comradef191/usb3sun/hardware/THT-PCB/usb3sun-THT.kicad_pcb

## KiCad design hardware/THT-PCB/usb3sun-THT.kicad_pcb (2024-04-11)

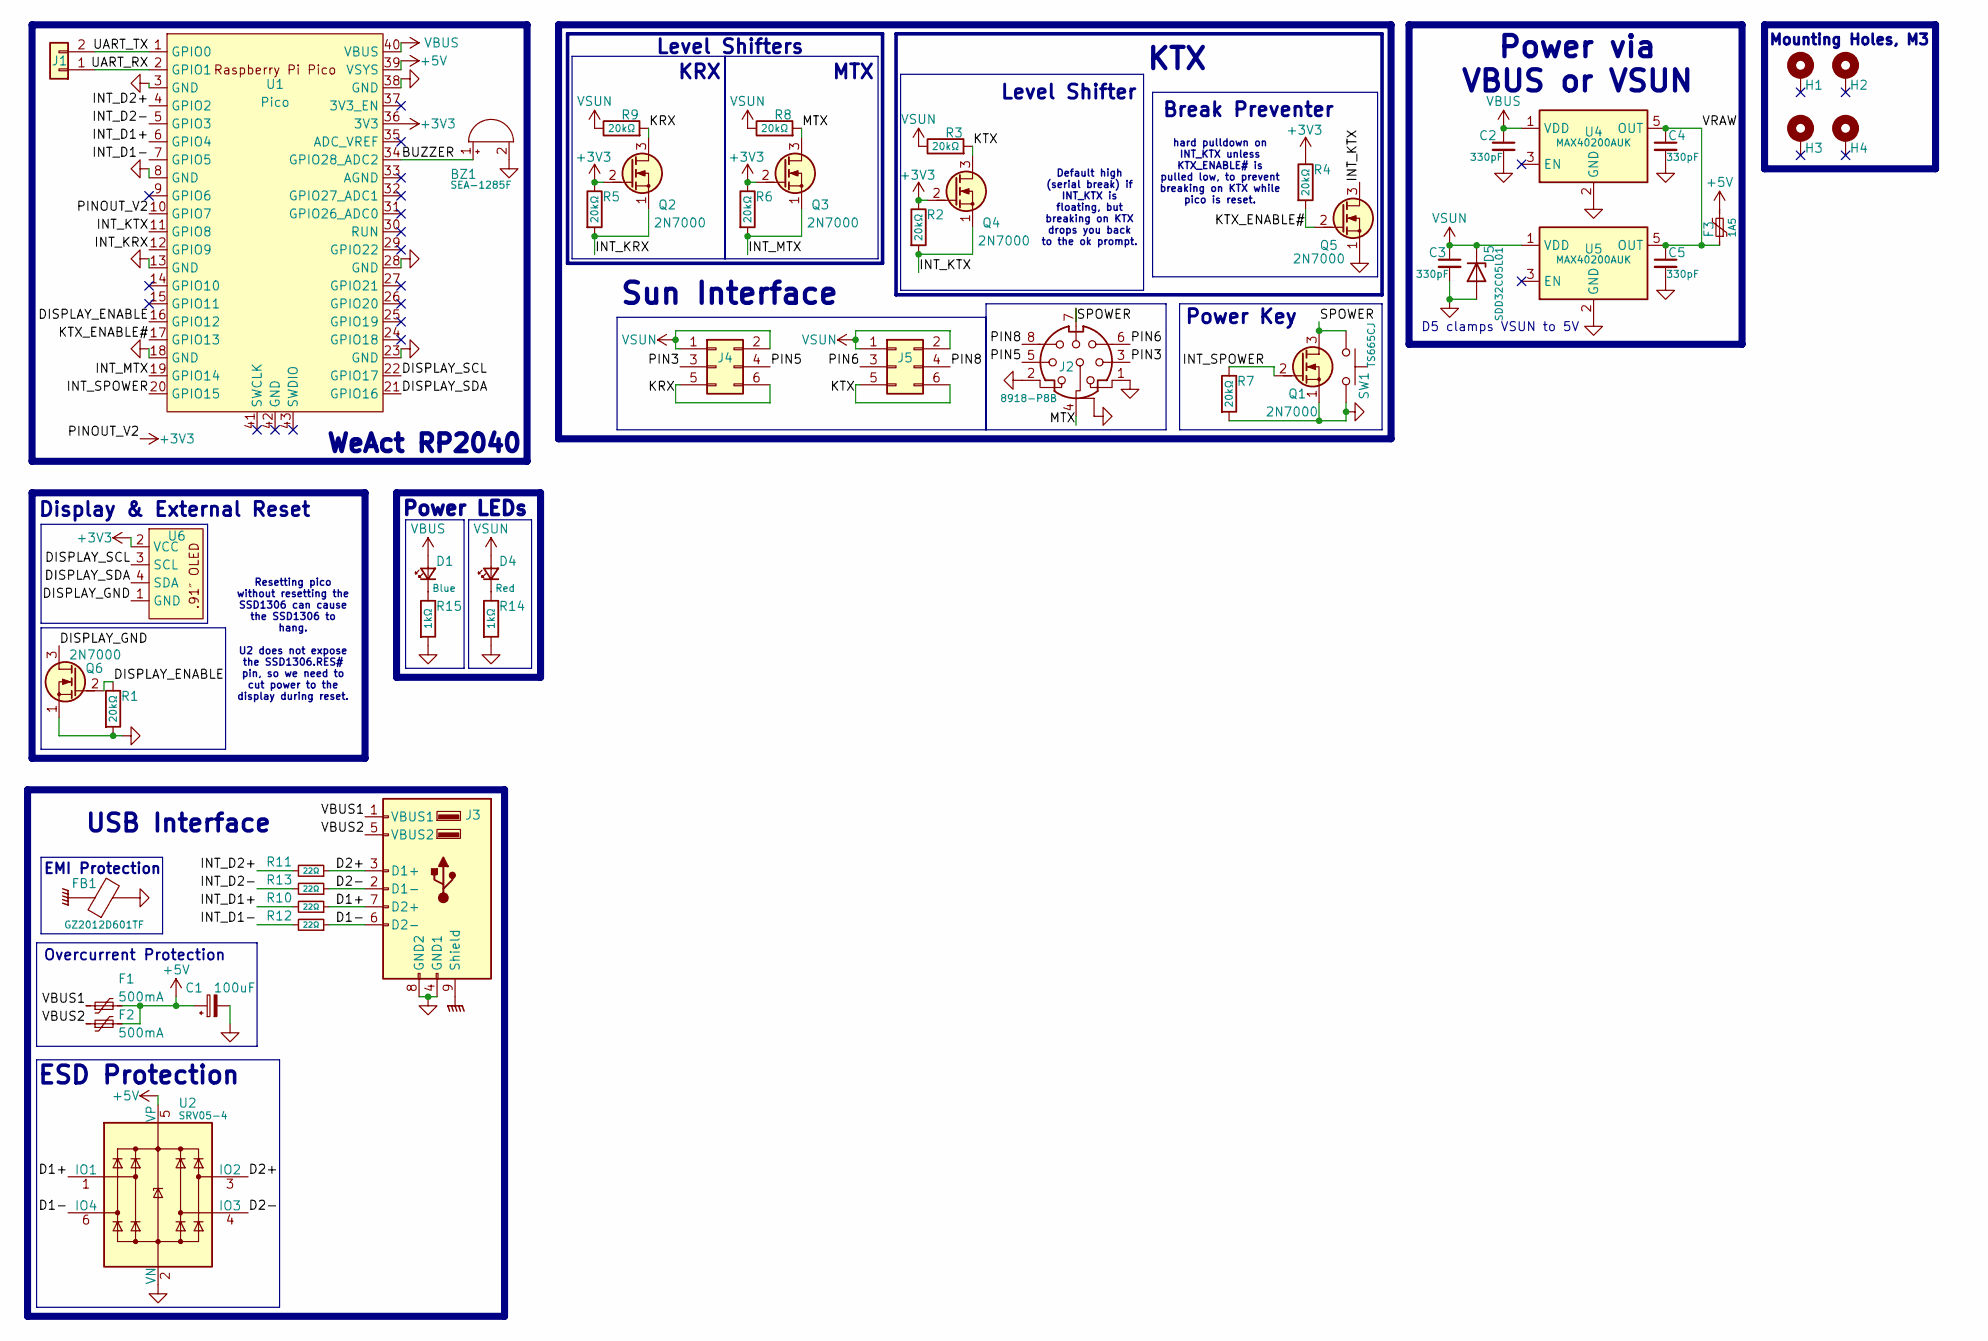
[picture p1: schematic usb3sun-THT.kicad_sch]

Parts:
BZ1: SEA-1285F; Buzzer_12x9.5RM7.6; LCSC C2693577
C1: 100uF; CP_EIA-3528-21_Kemet-B; LCSC C16133
C2, C3, C4, C5: 330pF; C_Disc_D3.8mm_W2.6mm_P2.50mm; LCSC C94711
D1: LED_D3.0mm; LCSC C2895474
D4: LED_D3.0mm; LCSC C440523
D5: SDD32C05L01; D_SOD-323_HandSoldering; LCSC C313311
F1, F2: 500mA; Fuse_1206_3216Metric; LCSC C70076
F3: 1A5; Fuse_1206_3216Metric; LCSC C70084
FB1: GZ2012D601TF; L_0805_2012Metric; LCSC C1017
H1, H2, H3, H4: MountingHole; MountingHole_3.2mm_M3_DIN965_Pad_TopBottom
J1: Conn_01x02; PinHeader_1x02_P2.54mm_Vertical
J2: 8918-P8B; Altronics_P1108_8918-P8B
J3: USB-U267-BWS; USB_A_CUI_UJ2-ADH-TH_Horizontal_Stacked; LCSC C2962392
J4, J5: Conn_02x03_Odd_Even; PinHeader_2x03_P2.54mm_Vertical
Q1, Q2, Q3, Q4, Q5, Q6: 2N7000; TO-92_Inline; LCSC C9114
R1, R2, R3, R4, R5, R6, R7, R8, R9: 20kΩ; R_Axial_DIN0207_L6.3mm_D2.5mm_P10.16mm_Horizontal
R10, R11, R12, R13: 22Ω; R_Axial_DIN0207_L6.3mm_D2.5mm_P10.16mm_Horizontal
R14, R15: 1kΩ; R_Axial_DIN0207_L6.3mm_D2.5mm_P10.16mm_Horizontal
SW1: TS665CJ; SW_PUSH_6mm_H4.3mm; LCSC C5340136
U1: Pico; Pico-BlackPill_Textless
U2: SRV05-4; SOT-23-6-routable; LCSC C85364
U4, U5: MAX40200AUK; SOT-23-5_HandSoldering; LCSC C2649430
U6: SSD1306-0.91-OLED-4pin-128x32

Connections:
+3V3: Q2.2 (G), Q3.2 (G), Q4.2 (G), R2.1, R4.1, R5.1, R6.1, U1.10 (GPIO7), U1.36 (3V3), U6.2 (VCC)
+5V: C1.1, F1.2, F2.2, F3.2, U1.39 (VSYS), U2.5 (VP)
/BUZZER: BZ1.1 (-), U1.34 (GPIO28_ADC2)
/D1+: J3.7 (D2+), R10.1, U2.1 (IO1)
/D1-: J3.6 (D2-), R12.1, U2.6 (IO4)
/D2+: J3.3 (D1+), R11.1, U2.3 (IO2)
/D2-: J3.2 (D1-), R13.1, U2.4 (IO3)
/DISPLAY_ENABLE: Q6.2 (G), R1.1, U1.16 (GPIO12)
/DISPLAY_GND: Q6.3 (D), U6.1 (GND)
/DISPLAY_SCL: U1.22 (GPIO17), U6.3 (SCL)
/DISPLAY_SDA: U1.21 (GPIO16), U6.4 (SDA)
/INT_D1+: R10.2, U1.6 (GPIO4)
/INT_D1-: R12.2, U1.7 (GPIO5)
/INT_D2+: R11.2, U1.4 (GPIO2)
/INT_D2-: R13.2, U1.5 (GPIO3)
/INT_KRX: Q2.1 (S), R5.2, U1.12 (GPIO9)
/INT_KTX: Q4.1 (S), Q5.3 (D), R2.2, U1.11 (GPIO8)
/INT_MTX: Q3.1 (S), R6.2, U1.19 (GPIO14)
/INT_SPOWER: Q1.2 (G), R7.1, U1.20 (GPIO15)
/KRX: J4.5, J4.6, Q2.3 (D), R9.2
/KTX: J5.5, J5.6, Q4.3 (D), R3.2
/KTX_ENABLE#: Q5.2 (G), R4.2, U1.17 (GPIO13)
/MTX: J2.4, Q3.3 (D), R8.2
/PIN3: J2.3, J4.3
/PIN5: J2.5, J4.4
/PIN6: J2.6, J5.3
/PIN8: J2.8, J5.4
/SPOWER: J2.7, Q1.3 (D), SW1.2
/UART_RX: J1.1, U1.2 (GPIO1)
/UART_TX: J1.2, U1.1 (GPIO0)
/VBUS1: F1.1, J3.1 (VBUS1)
/VBUS2: F2.1, J3.5 (VBUS2)
/VRAW: C4.1, C5.1, F3.1, U4.5 (OUT), U5.5 (OUT)
GND: BZ1.2 (+), C1.2, C2.2, C3.2, C4.2, C5.2, D5.2 (A), FB1.2, J2.1, J2.2, J2.SHIELD, J3.4 (GND1), J3.8 (GND2), Q1.1 (S), Q5.1 (S), Q6.1 (S), R1.2, R7.2, R14.2, R15.2, SW1.1, U1.3 (GND), U1.8 (GND), U1.13 (GND), U1.18 (GND), U1.23 (GND), U1.28 (GND), U1.38 (GND), U2.2 (VN), U4.2 (GND), U5.2 (GND)
GNDPWR: FB1.1, J3.9 (Shield)
unnamed: D1.1 (K), R15.1
unnamed: D4.1 (K), R14.1
VBUS: C2.1, D1.2 (A), U1.40 (VBUS), U4.1 (VDD)
VSUN: C3.1, D4.2 (A), D5.1 (K), J4.1, J4.2, J5.1, J5.2, R3.1, R8.1, R9.1, U5.1 (VDD)

Notes on the sheet:
Default high (serial break) if INT_KTX is floating, but breaking on KTX drops you back to the ok prompt.
hard pulldown on INT_KTX unless KTX_ENABLE# is pulled low, to prevent breaking on KTX while pico is reset.
Resetting pico without resetting the SSD1306 can cause the SSD1306 to hang. U2 does not expose the SSD1306.RES# pin, so we need to cut power to the display during reset.
KTX
WeAct RP2040
Mounting Holes, M3
Break Preventer
Overcurrent Protection
ESD Protection
Sun Interface
EMI Protection
Power Key
Power via VBUS or VSUN
Display & External Reset
USB Interface
KRX
D5 clamps VSUN to 5V
Level Shifters
MTX
Level Shifter
Power LEDs

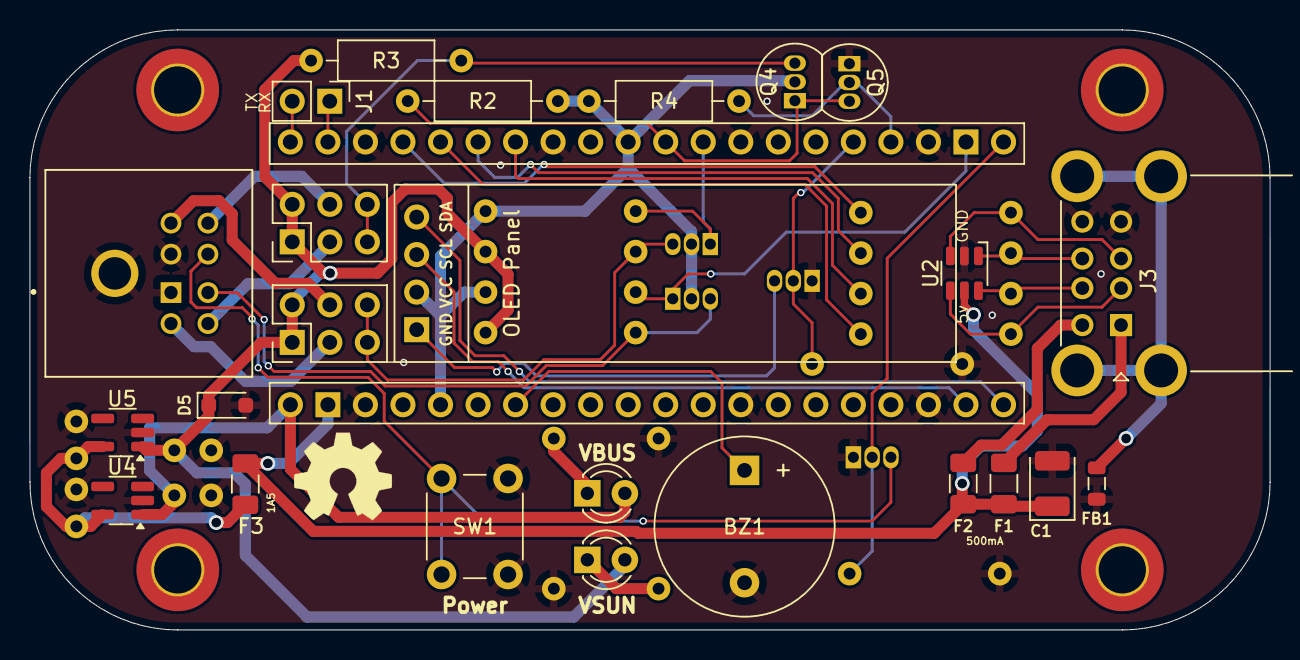
[picture p2: board usb3sun-THT.kicad_pcb from above]

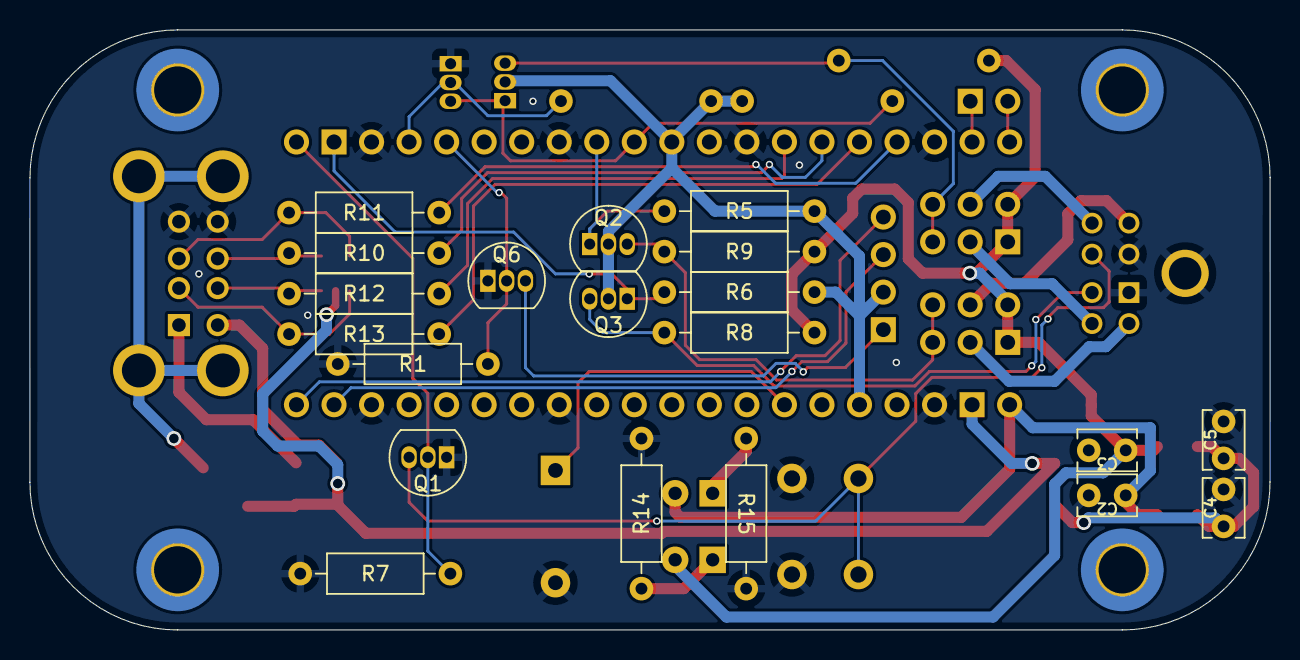
[picture p3: board usb3sun-THT.kicad_pcb from below]

Board: 2 copper layers, 83.9 x 40.6 mm, 49 parts (21 on the bottom side), 39 nets.
