comradef191/usb3sun/(commit log)

2024-03-10 Initial KiCAD Files
    [usb3sun-THT.kicad_pcb, usb3sun-THT.kicad_sch]
2024-03-10 Initial Schematic Copy & Organisation Removed redundant reset switch Removed redundant USB port Removed redundant Debug Header
    [usb3sun-THT.kicad_sch]
2024-03-10 Change fets to match original refs
    [usb3sun-THT.kicad_sch]
2024-03-10 SCH Complete; Begin PCB work!
    [usb3sun-THT.kicad_pcb, usb3sun-THT.kicad_sch]
2024-03-10 Simplification of LED circuits
    [usb3sun-THT.kicad_sch]
2024-03-10 SCH Improvements
    [usb3sun-THT.kicad_sch]
2024-03-28 Complete PCB layout, Further schematic adjustments; TODO traces
    [usb3sun-THT.kicad_pcb, usb3sun-THT.kicad_sch]
2024-03-29 Fully Routed
    [usb3sun-THT.kicad_pcb, usb3sun-THT.kicad_sch]
2024-03-29 Cleanup, Footprint location reshuffling
    [usb3sun-THT.kicad_pcb]
2024-03-29 Add UART Header
    [usb3sun-THT.kicad_pcb, usb3sun-THT.kicad_sch]
2024-04-11 PCB work
    [usb3sun-THT.kicad_pcb]
2024-04-11 Fix Sun connector, add connector config jumpers
    [usb3sun-THT.kicad_pcb, usb3sun-THT.kicad_sch]
